Luuuy2007/stm32-wenshidujiance/README.md

# 基于STM32的温湿度检测系统

摘　　要
针对仓储、机房与实验室等场合对温湿度巡检的低功耗与低成本要求，设计一款以 STM32G030K6T6 为主控的便携式温湿度检测装置。硬件以 SHT40 数字传感器为测量单元，经 I²C1 接口读取原始数据并按器件手册给出的线性关系换算温度与相对湿度；显示单元由三片 SN74HC595 移位寄存器分别承担段码与位选驱动，构成两组三位共阴数码管的动态扫描电路；供电取自两节 AAA 电池，经 P 沟道场效应管接入系统电源网络，并由磁珠隔离出单片机专用电源，另设电阻分压支路用于电池电压采样。软件采用事件驱动的休眠唤醒结构，按键下降沿经外部中断唤醒内核，定时器周期触发中断完成六位数码管刷新，中断服务程序的实际刷新周期约为 330 μs，刷新计数达到设定门限后关闭显示并返回睡眠，使装置绝大部分时间处于等待状态。工程编译结果为代码 10120 字节、只读数据 352 字节、读写数据 48 字节与未初始化数据 1896 字节，占用 Flash 约 10.3 kB、RAM 约 1.9 kB。电路仿真结果显示电源分压与电池采样、总线上升沿时间以及段驱动电流均处于设计允许范围。
关键词：STM32G030；SHT40；温湿度检测；移位寄存器；动态扫描；低功耗

第 1 章  绪论
1.1 课题背景与意义
温湿度是仓储、生产车间、机房与实验室中最常被监测的两类环境参数。粮食与药品在湿度偏高的环境中容易吸潮霉变，精密仪器在温度波动较大的场合会出现零点漂移，档案库房与古籍阅览室对湿度变化的敏感程度也远高于一般房间[1]。人工巡检依赖手持仪表逐点记录，采样间隔长，数据无法连续反映环境变化，遇到多点位场所时人力成本迅速上升。固定式监测系统解决了连续性的问题，其代价是布线复杂、安装位置受限，对于临时点位或空间狭小的场所并不适用。
嵌入式技术的成熟使便携式检测装置具备了实用条件。微控制器集成度提高、数字传感器出厂即完成标定、电池供电下的静态电流降到微安级，这三项变化让一台小型装置可以长期值守而无需外部电源。本课题以温湿度检测装置为对象，研究在有限硬件资源与电池供电约束下的电路与程序设计方法，对同类便携式环境检测设备的开发具有参考价值，也符合电气工程及其自动化专业在嵌入式系统与电力电子器件应用方面的培养要求。
1.2 国内外研究现状
低功耗设计是此类装置的研究重点。有研究以 STM32 微控制器为核心构建物联网设备，从系统架构、外设使能与通信技术三个层面讨论功耗控制策略，测试结果表明优化后的整机功耗明显下降[2]。采集环节的功耗控制依赖器件的休眠管理与外设电源通断，有研究在数据采集仪中选用低功耗微控制器，利用场效应管切换外设供电，并在软件中采用定时休眠策略降低整机平均电流[3]。面向特定场所的温湿度传感装置也有专门设计，有研究为空间狭小且易受潮的变电站端子箱开发了兼具无线与有线通信功能的多功能传感器，采用低功耗微处理器与集成温湿度敏感元件，适应了柜内环境的安装与维护条件[4]。
数据采集系统的架构设计积累了较多工程经验。面向烟草仓库的嵌入式监测系统将温湿度数据与图像数据融合，由数据采集节点、云服务器与远程监控终端三部分构成，其中采集节点以 ESP32 为核心完成环境参数的获取与上传[5]。针对固体表面温湿度的多路监测系统采用 STM32 作为主控，通过多路传感器实现对被测表面的连续采集，在腐蚀环境下的适应性得到验证[1]。成本与能耗的平衡也有专门讨论，基于近场通信的低能耗温湿度记录系统中，NFC 标签与主控芯片按需供电，降低了系统对电池容量的依赖[6]。传感器本身的精度保持问题同样受到重视，有研究依据数字式温湿度计校准规范对测量结果的不确定度进行分析评定，给出校准过程中的注意事项，指出定期校准是维持长期测量可信度的必要手段[7]。
现有研究多面向网络化、多点位的监测场景，通信模块与云端服务占据较大比重，对于单人操作、单点巡检的便携式仪表讨论相对较少。显示环节的技术选择也少有专门分析，而数码管动态扫描与移位寄存器驱动在低成本方案中具有典型意义。本文以一台便携式温湿度检测装置为对象，围绕供电、采集、显示与休眠四个环节展开设计，在不引入无线通信模块的前提下，通过事件驱动结构与器件选型降低整机功耗与成本。
1.3 主要研究内容
本文的研究工作包含硬件电路设计、嵌入式软件设计与电路仿真验证三部分。硬件部分完成电源通路与电池电压采样、单片机最小系统、数字传感器接口、移位寄存器显示驱动以及按键唤醒电路的设计，并给出元器件清单与印制板布局。软件部分完成系统时钟与外部设备的初始化、传感器数据读取与换算、数码管动态扫描刷新以及按键唤醒与休眠状态管理，给出各功能模块的程序流程与关键参数。仿真部分在电路仿真平台上对电源分压、总线上升沿与段驱动电流进行校核，以验证设计参数处于允许范围。

第 2 章  系统总体方案设计
2.1 功能需求与技术指标
装置面向单点巡检场景，要求在无人操作时保持低功耗待机，按下按键后立即读取当前温湿度并以数字形式显示，显示维持数秒后自动熄灭返回待机。测量范围覆盖常温环境，温度在 0 ℃ 至 50 ℃ 之间，相对湿度在 20 %RH 至 90 %RH 之间，温度分辨力不低于 0.1 ℃，湿度分辨力不低于 0.1 %RH。装置由两节 AAA 电池供电，待机状态下的电流应控制在微安量级，以满足长期值守的要求。整机体积受便携性约束，印制板尺寸为 60.0 mm × 30.0 mm。
2.2 主控芯片选型
主控承担数据读取、数值换算、显示扫描与休眠管理的任务，对运算能力要求不高，对静态功耗与封装尺寸要求较高。表 2-1 对三种常见方案进行了比较。STC89C52RC 属于传统 8051 内核，程序存储器与数据存储器容量偏小，片上外设有限，需要外加模数转换与较多辅助电路。STM32F103C8T6 采用 Cortex-M3 内核，资源充裕，封装为 LQFP48，静态电流与成本均高于本设计所需。STM32G030K6T6 属于 Cortex-M0+ 内核，主频 64 MHz，程序存储器 32 kB，数据存储器 8 kB，通用输入输出端口 30 个，工作电压 2 V 至 3.6 V，封装为 LQFP32，睡眠模式下电流较小，与两节 AAA 电池供电的方案匹配。
表 2-1  主控芯片方案比较
方案	内核	主频	程序存储器	数据存储器	封装	结论
STC89C52RC	8051	12 MHz	8 kB	512 B	DIP40	外设不足
STM32F103C8T6	Cortex-M3	72 MHz	64 kB	20 kB	LQFP48	成本与功耗偏高
STM32G030K6T6	Cortex-M0+	64 MHz	32 kB	8 kB	LQFP32	选用
2.3 温湿度传感器选型
传感器决定测量精度与接口复杂度。DHT11 采用单总线接口，价格低，精度为温度 ±2 ℃、湿度 ±5 %RH，分辨率较低，采集周期不低于 1 s，用于巡检仪表时误差偏大。SHT30 采用 I²C 接口，精度为温度 ±0.3 ℃、湿度 ±2 %RH，供电范围 2.4 V 至 5.5 V，性能满足要求。SHT40 同为 I²C 接口，精度提升至温度 ±0.2 ℃、湿度 ±1.8 %RH，供电范围 1.08 V 至 3.6 V，与 3 V 电池系统的电压区间吻合，无需额外稳压，且高精度测量命令的转换时间仅数毫秒，适合按键触发式的即时读取。三种方案的比较见表 2-2。

表 2-2  温湿度传感器方案比较
方案	接口	温度精度	湿度精度	供电范围	结论
DHT11	单总线	±2 ℃	±5 %RH	3.3 V ~ 5.5 V	精度不足
SHT30	I²C	±0.3 ℃	±2 %RH	2.4 V ~ 5.5 V	可用
SHT40	I²C	±0.2 ℃	±1.8 %RH	1.08 V ~ 3.6 V	选用
2.4 显示方案选型
显示单元需要在弱光环境下保持可读性，同时避免持续点亮的功耗。液晶字符模块 LCD1602 需要背光才能看清，背光电流通常在毫安级，与低功耗目标冲突，且低温下响应变慢。有机发光二极管模块对比度高、视角大，但成本与老化问题使其不适合长期值守的仪表。三位共阴数码管配合动态扫描的工作方式具有亮度高、成本低、静态不耗电的特点，显示仅在按键触发后的短暂时段内进行，与休眠结构契合。为压缩单片机端口占用，位数码管的段码与位选均由移位寄存器驱动，三种方案的比较见表 2-3。
表 2-3  显示方案比较
方案	显示内容	驱动方式	静态功耗	结论
LCD1602	字符两行	并口或 I²C	背光开启时毫安级	功耗偏高
OLED 模块	自发光点阵	I²C 或 SPI	点亮时毫安级	成本与老化
三位共阴数码管	两组三位数字	移位寄存器动态扫描	熄灭时不耗电	选用
2.5 系统总体结构
装置由供电、采集、主控、显示、交互与检测六个功能单元构成。两节 AAA 电池经 P 沟道场效应管接入系统电源网络，磁珠将单片机供电与外围供电隔离，抑制数字开关噪声对内核的干扰。温湿度传感器经四脚插座与 I²C1 总线连接，两条信号线各配一只上拉电阻。三片移位寄存器分别承担两只数码管的段码驱动与公共端位选，形成三组独立的串行接口，由单片机的六个端口分时控制。轻触开关一端接地、另一端接单片机的外部中断引脚，承担唤醒功能。电池电压经电阻分压后送入模数转换通道，用于电量估计。系统总体结构见图 2-1。

图 2-1  系统总体结构框图
2.6 器件成本与功耗估算
整机物料成本由芯片、显示器件与无源元件三部分构成。主控芯片选用 32 位内核的低成本型号，单价与常见 8 位机相当而外设资源更完整，省去了外部模数转换与存储扩展的开支。两只三位数码管与三片移位寄存器的组合总价低于同尺寸液晶模块，且不依赖背光，减少了长期运行的电能开销。阻容元件全部采用 0603 封装，贴片化布置有利于批量焊接与小型化。
功耗方面，装置在待机状态下内核处于等待中断模式，外设时钟除保持中断唤醒所需的端口外均被关闭，数码管与指示灯全部熄灭，电流消耗以场效应管的漏电流与阻容元件漏电流为主，处于微安量级。按键触发后的工作时段包含一次传感器测量与约 3.3 s 的显示刷新，段驱动电流平均值约 2.5 mA，其余外设处于空闲状态，按此估算，两节 AAA 电池在每日触发十次的典型使用频率下，续航明显长于常规巡检仪表的电池更换周期。

第 3 章  硬件电路设计
3.1 电源通路与电池电压检测
装置采用两节 AAA 电池串联供电，标称电压 3 V。电池正极直接引出 VBAT 网络，经 P 沟道场效应管 Q1 接入 3V 网络，管子的栅极接地使沟道保持导通，源漏之间的导通电阻为 52 mΩ，在百毫安级负载下产生的压降不超过数十毫伏。该管的接法同时承担电池反接保护，电池极性接反时栅源电压随之反向，沟道关断，后级电路与单片机不会因反向电压而损坏。单片机供电由 3V 网络经磁珠 L1 引出，形成独立的 VDD 网络，磁珠在 100 MHz 处的阻抗为 120 Ω，可将数码管动态扫描产生的高频开关噪声挡在内核供电之外。VDD 与地之间就近放置 100 nF 电容 C2，为内核提供高频去耦通路，3V 网络上并联四只 1 μF 电容 C5 至 C7 与 C9，用于抑制负载突变引起的电压波动。
电量检测由电阻 R6 与 R7 构成的分压支路完成。3V 网络经 R6 引入采样点 BAT_VOL，该点再经 R7 接地，两只电阻同为 10 kΩ，分压比为二分之一，3 V 电池电压在采样点上形成约 1.5 V 的直流分量，处于模数转换通道的输入范围之内。采样点并联 100 nF 电容 C8，滤除按键操作引起的瞬态干扰。采样信号接入单片机的 PB1 端口，该端口复用为模数转换通道 ADC1_IN9，转换器的采样时间配置为 160.5 个时钟周期，以适应分压支路较高的等效源阻抗。电源通路与电量检测电路见图 3-1。

图 3-1  电源通路与电池电压检测电路
3.2 单片机最小系统
单片机采用 STM32G030K6T6，封装为 LQFP32，程序存储器容量 32 kB，数据存储器容量 8 kB，通用输入输出端口 30 个，最高主频 64 MHz。时钟源选用内部高速振荡器，无需外部晶振即可启动，降低了物料成本与布板难度。复位电路由上拉电阻 R1 与电容 C1 构成，R1 取 10 kΩ 接至 3V 网络，C1 取 100 nF 接地，上电时电容两端电压不能突变，将复位引脚拉低一段时间，保证内部寄存器的可靠初始化。
仿真器与调试接口采用四针排针 H1，依次为 3V、地、时钟线与数据线，接至单片机的 PA13 与 PA14 端口，两端口分别复用为串行线调试的数据线与时钟线，下载程序与在线调试均通过该接口完成。板上另行接入 32.768 kHz 晶振 X1，两端分别接至 PC14 与 PC15 端口，各配 18 pF 负载电容 C3 与 C4。外部低速晶振在本设计中并未启用，配置文件中保留其引脚定义，为后续增加实时时钟与定时唤醒功能预留条件。单片机最小系统电路见图 3-2。

图 3-2  单片机最小系统电路
3.3 温湿度采集电路
温湿度传感器 SHT40 通过四脚插座 U2 接入，插座间距 1.27 mm，引脚依次为数据线、地、电源与时钟线。数据线 SHT40_SDA 接至单片机的 PB9 端口，时钟线 SHT40_SCL 接至 PB8 端口，二者分别复用为 I²C1 的数据与时钟信号，引脚配置为开漏输出模式并工作在 7 位地址方式，从机地址为 0x44。开漏输出无法主动拉高电平，两条信号线各接一只 4.7 kΩ 上拉电阻 R2 与 R3 至 3V 网络，总线在空闲状态由电阻拉至电源电平。传感器与单片机在同一块印制板上，总线走线短、分布电容小，4.7 kΩ 的上拉阻值与 400 kHz 的通信速率相适应，兼顾了上升沿速度与静态功耗。采集电路见图 3-3。

图 3-3  温湿度采集电路
3.4 显示驱动电路
显示单元由两只三位共阴数码管与三片 SN74HC595 移位寄存器组成。数码管型号为 FJ2381AH，字高 0.28 英寸，八段笔画按 A 至 H 顺序引出，其中 H 段为小数点，六个公共端分别对应两排数字的三位。移位寄存器 U3 的八路输出接第一只数码管的八段笔画，U4 的八路输出接第二只数码管的八段笔画，U5 的八路输出中有七路分别接两只数码管的六个公共端与一只信号指示灯，组成位选驱动。三片寄存器各自拥有独立的串行数据线、移位时钟线与锁存时钟线，并未采用级联连接，这样每片寄存器可以单独刷新，避免了级联方式下十六位串行传输带来的额外时间开销。
芯片的使能端接地使输出保持有效，清零端接至 3V 网络避免误清零，电源与地之间就近配置去耦电容。共阴极数码管的公共端由 U5 输出驱动，输出低电平时对应的位被选中，段码由 U3 与 U4 输出高电平点亮，两个方向的驱动电流均在器件允许范围之内。显示驱动电路见图 3-4。

图 3-4  显示驱动电路
3.5 按键唤醒电路
轻触开关 SW1 为单刀单掷结构，触点额定电流 50 mA，机械寿命 10 万次，一端接地，另一端经 WAKE 网络接至单片机的 PB5 端口。该端口配置为下降沿触发的外部中断输入，内部上拉电阻使能，开关断开时端口保持高电平，按下时端口经开关接地，产生下降沿触发中断。内部上拉免去了外部上拉电阻，简化了电路。板上另设两只蓝色发光二极管。LED4 作为工作指示，阳极经 4.7 kΩ 限流电阻 R5 接至 3V 网络，阴极接至 PB7 端口，端口输出高电平时指示灯熄灭，输出低电平时点亮，该引脚在初始化阶段被置为高电平，与软件中关闭指示灯的操作一致。LED3 作为信号指示，阳极经 4.7 kΩ 限流电阻 R4 接至 3V 网络，阴极接至位选寄存器 U5 的 Q6 输出端，驱动路径已在 3.4 节的显示驱动电路中给出，当前固件未点亮该指示，作为运行状态的预留通道。按键与指示电路见图 3-5。

图 3-5  按键唤醒与指示电路
3.6 元器件清单与印制板布局
整板共 31 个元器件，包含主控芯片一只、移位寄存器三片、三位共阴数码管两只、场效应管一只、电池盒一只、连接器与排针各一只、晶振一只、磁珠一只、发光二极管两只、轻触开关一只、贴片电阻七只与贴片电容九只。元器件清单见表 3-1，其中电阻与电容按标称阻值、容值与精度列入。
表 3-1  元器件清单
序号	位号	名称与规格	封装	数量
1	U1	STM32G030K6T6 微控制器	LQFP32	1
2	U3, U4, U5	SN74HC595PWR 移位寄存器	TSSOP-16	3
3	LED1, LED2	FJ2381AH 三位共阴数码管	直插 0.28 英寸	2
4	U2	X1311FR-04-C43D24 四脚插座	1.27 mm 间距	1
5	H1	X6511WV-04H-C60D30 四针排针	2.54 mm 间距	1
6	Q1	WST3401 P 沟道场效应管	SOT-23-3	1
7	BAT1	BH-AAA-A1AJ020 电池盒	AAA 直插	1
8	X1	X321532768KGD2SI 晶振 32.768 kHz	SMD 3.2×1.5	1
9	L1	PBBMAQ2012G-121T08 磁珠 120 Ω	0805	1
10	SW1	GT-TC018A-H0375-L1 轻触开关	卧贴 4.7×3.5	1
11	LED3, LED4	XL-1608UBC-04 蓝色发光二极管	0603	2
12	R6, R7	AR03BTCX1002 精密电阻 10 kΩ ±0.1 %	0603	2
13	R1	0603WAF1002T5E 电阻 10 kΩ ±1 %	0603	1
14	R2, R3, R4, R5	0603WAF4701T5E 电阻 4.7 kΩ ±1 %	0603	4
15	C1, C2, C8	CC0603KRX7R9BB104 电容 100 nF X7R	0603	3
16	C5, C6, C7, C9	CL10A105KB8NNNC 电容 1 μF X5R	0603	4
17	C3, C4	CL10C180JB8NNNC 电容 18 pF C0G	0603	2
印制板采用长 60.0 mm、宽 30.0 mm 的矩形板框，四角圆角半径为 2.0 mm。板面按功能划分为三个区域，左侧布置电池盒与调试排针，中部集中放置单片机、晶振与电源器件，右侧放置三片移位寄存器与两只数码管。传感器插座布置在板右上方并与单片机保持短距离走线，两只上拉电阻紧靠插座放置。数码管沿板长方向排列，位选寄存器置于两只数码管之间以缩短位选走线。电池盒布置在板背面，以节省正面面积。印制板元件布局见图 3-6。

图 3-6  印制板元件布局图

第 4 章  软件设计
4.1 软件总体结构
程序以事件驱动方式组织，不使用操作系统。上电后完成系统初始化，随即关闭显示并进入睡眠状态，内核在等待中断指令处挂起，绝大部分时间不再执行任何指令。按键按下时外部中断置位按键状态标志并恢复系统滴答定时器，主循环检测到标志后读取传感器数据、启动定时器刷新显示，刷新计数达到门限后关闭显示并重新进入睡眠。整个程序由主循环、中断服务程序与若干功能函数构成，模块之间通过全局结构体变量传递状态，结构简单且时序可控。主程序流程见图 4-1。

图 4-1  主程序流程图
4.2 系统时钟与外设初始化
系统时钟由内部高速振荡器经锁相环倍频得到。内部振荡器标称频率 16 MHz，锁相环输入分频系数取 1，倍频系数取 8，输出分频系数取 2，压控振荡器输出 128 MHz，经分频后系统时钟为 64 MHz，总线时钟与定时器时钟同为 64 MHz。闪存等待周期设置为 2 个周期，与 64 MHz 的主频相适应。时钟配置在系统时钟函数中完成，配置失败时进入错误处理函数并关闭中断。
外设初始化按端口、模数转换、串行总线与定时器的顺序执行。端口初始化将十个引脚配置为推挽输出并设置最高翻转速度，用于驱动三组移位寄存器，另将指示灯引脚置为高电平状态。串行总线配置为 7 位地址方式，时序寄存器按 64 MHz 时钟与 400 kHz 速率写入固定参数，模拟滤波器使能、数字滤波器关闭。定时器配置为向上计数模式，预分频系数 63，自动重装值 29，更新中断使能，中断优先级低于外部中断但高于滴答定时器。各初始化函数由代码生成工具产生，用户代码段保持独立，便于后续修改。
4.3 温湿度数据读取与换算
读取函数通过 I²C1 总线以主机发送方式向传感器写入单字节命令 0xFD，该命令对应最高重复性下的温湿度测量，转换时间约 8.3 ms，程序调用延时函数等待 10 ms 以保证转换完成。随后以主机接收方式读回六个字节，依次为温度高字节、温度低字节、温度校验字节、湿度高字节、湿度低字节与湿度校验字节。温度与湿度的原始值均为 16 位无符号数，按器件手册给出的线性关系换算，温度等于原始值乘以 175 除以 65535 再减去 45，相对湿度等于原始值乘以 125 除以 65535 再减去 6。十六位原始值对应 175 ℃ 的温度跨度，理论分辨力约为 0.0027 ℃，换算结果乘以十并取整后存入设备参数结构体，整型变量的分辨力为 0.1 ℃，满足显示要求。读取流程见图 4-2。

图 4-2  温湿度数据读取流程
4.4 数码管动态扫描与显示刷新
显示采用分时扫描方式，六个数字位由位选寄存器依次选通，段码寄存器同步输出对应当前位的笔画编码。位选编码为八位数据，仅有一位为低电平，其余位为高电平，低电平位对应的数码管公共端被拉低而点亮。两排数字的位选编码分别为 0xFE、0xFD、0xFB 与 0xF7、0xEF、0xDF，分别对应第一只数码管的三个位与第二只数码管的三个位。段码采用七段编码表，数字 0 至 9 的编码依次为 0x3F、0x06、0x5B、0x4F、0x66、0x6D、0x7D、0x07、0x7F 与 0x6F，小数点的编码为 0x80。十位数字的段码与 0x80 按位或运算后写入寄存器，使十位后的小数点常亮，从而以一位小数的形式显示测量结果，段码表见表 4-1，位选编码见表 4-2。
表 4-1  数码管段码表
显示字符	段码	显示字符	段码
0	0x3F	5	0x6D
1	0x06	6	0x7D
2	0x5B	7	0x07
3	0x4F	8	0x7F
4	0x66	9	0x6F
表 4-2  数码管位选编码表
显示位置	位选编码	选通位	显示内容
第一排第 1 位	0xFE	U5 输出第 0 位	温度百位
第一排第 2 位	0xFD	U5 输出第 1 位	温度十位带小数点
第一排第 3 位	0xFB	U5 输出第 2 位	温度个位
第二排第 1 位	0xF7	U5 输出第 3 位	湿度百位
第二排第 2 位	0xEF	U5 输出第 4 位	湿度十位带小数点
第二排第 3 位	0xDF	U5 输出第 5 位	湿度个位
位选与段码的写入由移位函数完成。函数按照高位在前的顺序逐位输出数据，每输出一位时先将数据线置为对应电平，再在移位时钟线上产生一个上升沿，使数据移入寄存器，八位数据全部移入后在锁存时钟线上产生上升沿，将移位结果送入输出寄存器。每次显示一位后调用约 50 μs 的延时函数，随后将段码寄存器清零以消除残影，避免相邻位之间因余辉产生错位显示。定时器中断服务程序先关闭中断，依次刷新六个数字位，再将计数器清零并重新启动中断，刷新计数变量同步自增，用于判断是否达到休眠门限。定时器中断流程见图 4-3。

图 4-3  定时器中断与显示刷新流程
4.5 按键唤醒与低功耗管理
低功耗管理依靠内核睡眠模式与中断唤醒机制实现。进入睡眠之前，程序关闭数码管与指示灯的全部输出，随后调用挂起滴答定时器函数停止系统滴答计数，再执行等待中断指令使内核停止取指。系统滴答定时器在睡眠期间若继续计数，其周期性中断会不断将内核唤醒，挂起滴答定时器是保证内核持续处于睡眠状态的前提。按键按下时，PB5 端口产生下降沿，外部中断线触发中断服务程序，回调函数将按键状态置为消抖状态并恢复滴答定时器，内核随即从等待中断指令之后继续执行。主循环检测到按键状态标志后再次读取端口电平确认按键确实按下，并等待电平恢复以避免重复触发。休眠与唤醒的状态转移见图 4-4。

图 4-4  休眠与唤醒状态转移图
4.6 关键参数计算
显示刷新周期由定时器参数与刷新耗时共同决定。定时器计数时钟为 1 MHz，自动重装值为 29，定时周期为 30 μs。中断服务程序每次刷新六个数字位，每个数字位的位移输出耗时约数微秒，消影延时约 50 μs，单次中断处理耗时约 300 μs，明显大于定时周期，因此实际刷新周期由处理耗时决定，约为 330 μs，六位数码管的完整刷新率接近 3 kHz，远高于人眼产生闪烁感所需的 50 Hz。刷新计数门限设为 5000 次，对应的显示维持时间约为 1.65 s，计数溢出两次后进入休眠，装置从按下按键到自动熄灭的总时间约为 3.3 s。关键参数的计算结果见表 4-3。
表 4-3  关键参数计算结果
参数	算式	结果
系统时钟	16 MHz × 8 ÷ 2	64 MHz
定时器计数时钟	64 MHz ÷ (63 + 1)	1 MHz
定时器中断周期	(29 + 1) ÷ 1 MHz	30 μs
显示维持时间	5000 × 330 μs	约 1.65 s
自动熄灭时间	2 × 1.65 s	约 3.3 s
数码管刷新率	1 ÷ 330 μs	约 3 kHz
显示分辨力	1 ÷ 10	0.1 ℃
程序编译采用 ARM 编译器第五版，优化等级为最高级，编译结果为代码 10120 字节、只读数据 352 字节、读写数据 48 字节与未初始化数据 1896 字节，无错误与警告。按此结果计算，程序占用闪存约 10.3 kB，占 32 kB 容量的百分之三十二，运行时占用数据存储器约 1.9 kB，占 8 kB 容量的百分之二十四，存储资源留有余量，可支撑后续增加实时时钟、数据存储与通信功能。

第 5 章  电路仿真与结果分析
5.1 仿真平台与模型建立
本章通过解析计算与电路仿真两种方式对关键节点进行校核，仿真在立创EDA 专业版环境中进行，模型直接取自原理图对应的网络连接，元器件参数按元器件清单中的标称值设定，未参与仿真验证的模块在模型中予以简化。校核对象集中在三处需要定量确认的环节，分别为电池分压采样支路、I²C 总线的上拉与上升沿，以及数码管的段驱动电流。这三处决定了采样通道可用性、通信可靠性与显示器件工作余量，其余部分属于数字逻辑连接，通过程序流程与引脚配置即可确认，不再单独仿真。
5.2 电池分压与采样校核
分压支路由两只 10 kΩ 电阻串联构成，分压比为一比一，采样模型与等效电路见图 5-1。电池电压为标称值 3 V 时，采样点电压为 1.5 V，处于模数转换通道的线性输入范围之内。分压支路的等效源阻抗为两只电阻的并联值 5 kΩ，与采样点并联的 100 nF 电容构成一阶低通网络，时间常数约为 500 μs，对应截止频率约 318 Hz，可以滤除按键动作与数码管扫描引入的高频扰动，同时对缓慢变化的电池电压不产生衰减。转换器采样时间设置为 160.5 个时钟周期，在 64 MHz 的转换时钟下对应约 2.5 μs 的采样窗口，远小于滤波网络的时间常数，采样期间电容电压的跌落可以忽略。采样通道在当前固件中未启用，作为电量显示的预留接口保留。

图 5-1  电池分压采样等效电路
5.3 I²C 总线上升沿校核
总线的两条信号线各经一只 4.7 kΩ 电阻上拉至 3V 网络，仿真模型与上升沿计算曲线见图 5-2。总线分布电容的取值由走线长度与器件引脚电容决定，本设计中传感器插座与单片机相邻，走线长度不足 50 mm，分布电容按 50 pF 估算。上拉电阻与分布电容构成充电回路，时间常数为 235 ns，电压由 0.3 倍电源电压上升至 0.7 倍电源电压所需的时间为 199 ns。I²C 快速模式对这一区间上升时间的要求为不超过 300 ns，标准模式的要求为不超过 1000 ns，两种模式下 4.7 kΩ 的上拉阻值均留有裕量。阻值继续增大会使上升沿变缓，减小则会抬高总线被拉低时的瞬时电流，4.7 kΩ 在上升速度与静态电流之间取得平衡。总线空闲时两条信号线由上拉电阻维持高电平，不消耗静态电流，与低功耗目标一致。

图 5-2  I²C 总线等效模型与上升沿计算曲线
5.4 段驱动电流校核
数码管的段码由移位寄存器直接驱动，未设串联限流电阻，驱动电流路径见图 5-3。电流由电源电压、发光二极管正向压降与移位寄存器输出内阻共同决定。红色发光二极管在正常工作电流下的正向压降约为 1.9 V，3 V 供电时输出端与二极管之间的电位差约 1.1 V，移位寄存器在高电平输出状态下的等效内阻约为 70 Ω，据此估算段电流峰值约为 15 mA。器件单引脚输出的绝对最大电流为 35 mA，峰值电流处于允许范围之内。显示采用动态扫描方式，每只数码管的三个位依次点亮，单个位的导通时间占完整刷新周期的六分之一，段电流的平均值降至约 2.5 mA，发光亮度在扫描频率接近 3 kHz 时不会出现可察觉的频闪。

图 5-3  段驱动电流路径
5.5 仿真结果汇总
三处校核环节的关键量值与判定结果汇总于表 5-1。电源分压支路的采样电压、总线上升时间与段电流峰值均处于设计允许范围，设计参数无需调整。分压支路的两只精密电阻精度为 ±0.1 %，温度系数为 ±25 ppm/℃，在常温范围内的分压比误差可忽略；上拉电阻的精度为 ±1 %，对上升时间的影响小于百分之二。综合三处校核结果，电路参数满足测量、通信与显示三方面的功能要求。
表 5-1  仿真校核结果汇总
校核项目	参数设置	计算结果	判定限值	结论
采样点电压	R6 = R7 = 10 kΩ，电池 3 V	1.50 V	0 ~ 3 V	满足
滤波截止频率	5 kΩ ∥ 100 nF	318 Hz	低于扰动频率	满足
I²C 上升时间	4.7 kΩ，总线电容 50 pF	199 ns	快速模式 ≤ 300 ns	满足
段电流峰值	3 V 供电，输出内阻约 70 Ω	约 15 mA	≤ 35 mA	满足
段电流平均值	动态扫描占空比 1/6	约 2.5 mA	低于连续额定值	满足

第 6 章  结论与展望
6.1 结论
本文设计了一台以 STM32G030K6T6 为主控的便携式温湿度检测装置，完成了硬件电路设计、嵌入式软件设计与电路参数校核三部分工作。硬件方面，装置以两节 AAA 电池供电，经 P 沟道场效应管接入系统电源网络并用磁珠隔离单片机电源，数字传感器 SHT40 通过 I²C1 总线接入，两只 4.7 kΩ 电阻构成总线上拉，三片 SN74HC595 移位寄存器以三组独立的三线接口分别驱动两只三位共阴数码管的段码与位选，轻触开关接至外部中断引脚承担唤醒功能，整板共 31 个元器件，印制板尺寸为 60.0 mm × 30.0 mm。软件方面，程序采用事件驱动结构组织，系统时钟由内部振荡器经锁相环倍频至 64 MHz，传感器数据按器件手册的线性关系换算并放大十倍取整，定时器以 30 μs 周期触发中断，中断服务程序的实际刷新周期约 330 μs，显示维持约 1.65 s 后自动熄灭，装置在按下按键到返回睡眠的整个过程中仅有一次数据采集与数秒的显示动作，其余时间内核处于等待中断状态。
编译结果显示程序占用闪存约 10.3 kB、数据存储器约 1.9 kB，在 32 kB 与 8 kB 的容量中分别占百分之三十二与百分之二十四，资源留有余量。电路校核结果表明，电池分压支路的采样电压为 1.5 V，滤波网络截止频率 318 Hz，I²C 总线在 4.7 kΩ 上拉与 50 pF 分布电容条件下上升时间为 199 ns，段驱动电流峰值约 15 mA、平均值约 2.5 mA，各项参数均处于器件允许范围，设计参数的选取是合理的。与网络化监测系统相比，本设计放弃了无线通信与云端存储，以单点即时读取为目标换取更低的静态功耗与更简单的硬件结构，适合作为仓储巡检、设备点检等场景中的便携工具。
6.2 展望
当前设计仍存在可改进之处。传感器返回的六个字节中包含两个校验字节，程序在读取时未对校验字节进行核对，总线受到干扰时可能将错误数据当作有效结果，后续可在读取函数中补充循环冗余校验的计算与判断。电池电压采样通道已在硬件与配置中预留，但未在程序中启用，增加一次转换并配合电压阈值判断即可实现低电量提示。板上接入的 32.768 kHz 晶振尚未启用，开启外部低速振荡器后可以借助实时时钟实现定时唤醒与定时记录，使装置由被动响应按键转为周期性自动采集。显示方面，两组三位数字仅能表达当前测量值，增加存储芯片后可以保留历史极值，为环境趋势判断提供依据。

致　　谢
本文的完成得到指导教师在选题、方案论证与电路调试各阶段的指导，教师在器件选型依据与低功耗设计思路方面给出的意见，使设计从最初的通用方案收敛到可实现的电路结构。感谢我的挚友为我提供了可靠的大模型和足量的Token帮助我完成制板部分的配件选型和代码部分的语法验证。在各环节中帮助过我的老师们和同学们在此一并表示感谢。
受个人水平限制，文中难免存在不足，恳请各位老师批评指正。

参考文献
[1] 王玉荣.测量固体表面温湿度的多路监测系统设计[J].自动化与仪器仪表,2024(12):214-219.
[2] 秦顾艺.基于STM32的物联网设备低功耗设计与优化[J].产业创新研究,2024(20):130-132.
[3] 程智,熊远生,高金凤.基于NB-IoT的地下管网数据采集仪设计[J].计算技术与自动化,2024(4):10-15.
[4] 张敏,方健,王勇,等.基于ZigBee无线通信的变电站端子箱温湿度传感器系统设计[J].制造业自动化,2023(2):169-174.
[5] 何强,王武.基于物联网的烟草仓库嵌入式监测系统设计[J]. 自动化与仪表, 2024(7):72-74.
[6] 黄勇萍.基于NFC的低能耗温湿度记录系统的设计与实现[J].信息与电脑(理论版),2023(3):147-149.
[7] 潘雯雯.浅谈数字式温湿度计不确定度评定及校准[J].仪器仪表标准化与计量,2025(3):40-42.

附录 A  整机原理图
整机原理图按功能划分为滤波磁珠、主控电路、复位电路、晶振电路、温湿度传感器模块、移位寄存器与寄存器滤波电容、数码管、电池电量测量电路、电池防反接电路、唤醒按键、信号指示与测试指示以及下载调试接口等单元，各单元的元件位号与网络名称与正文第 3 章一致。

图 A-1  整机原理图
原理图

附录 B  PCB 封装图
印制板采用双面布局，正面放置贴片阻容、集成电路、数码管与连接器，背面放置电池盒。板框尺寸为 60.0 mm × 30.0 mm，四角圆角半径 2.0 mm，共 31 个元件、159 个焊盘。顶层走线集中在左侧主控区与中部移位寄存器区之间，两只数码管与传感器插座布置在右侧，底层以大面积铺地与电池盒开窗为主。印制板顶层与底层图分别见图 B-1 与图 B-2。

图 B-1  印制板顶层图
印制板顶层

图 B-2  印制板底层图
印制板底层

附录 C  装配效果图
装配效果图

装配效果图给出装置的三维形态。印制板正面左侧布置单片机、电源器件与四针调试排针，中部为三片移位寄存器及其去耦电容，右侧为传感器插座与两只总线上拉电阻，两只三位共阴数码管沿板长方向并排安装并朝向正面，字面在正视方向可读。电池盒固定在印制板背面，与正面的元件位置相互错开，整机厚度主要由数码管与电池盒决定。

图 C-1  装配效果图

附录 D  元器件清单
清单按位号列出全部 31 个元器件，型号与封装信息取自原理图与封装图文件。
表 D-1  元器件清单
序号	位号	名称与规格	封装	数量
1	U1	STM32G030K6T6 微控制器	LQFP32	1
2	U2	X1311FR-04-C43D24 四脚插座 1.27 mm	弯插 4P	1
3	U3, U4, U5	SN74HC595PWR 移位寄存器	TSSOP-16	3
4	LED1, LED2	FJ2381AH 三位共阴数码管 0.28 英寸	直插	2
5	LED3, LED4	XL-1608UBC-04 蓝色发光二极管	0603	2
6	Q1	WST3401 P 沟道场效应管 30 V/5.5 A	SOT-23-3	1
7	BAT1	BH-AAA-A1AJ020 电池盒	AAA 直插	1
8	SW1	GT-TC018A-H0375-L1 轻触开关	卧贴	1
9	X1	X321532768KGD2SI 晶振 32.768 kHz	SMD 3.2×1.5	1
10	L1	PBBMAQ2012G-121T08 磁珠 120 Ω@100 MHz	0805	1
11	H1	X6511WV-04H-C60D30 四针排针 2.54 mm	直插	1
12	R1	0603WAF1002T5E 电阻 10 kΩ ±1 %	0603	1
13	R2, R3, R4, R5	0603WAF4701T5E 电阻 4.7 kΩ ±1 %	0603	4
14	R6, R7	AR03BTCX1002 电阻 10 kΩ ±0.1 %	0603	2
15	C1, C2, C8	CC0603KRX7R9BB104 电容 100 nF X7R 50 V	0603	3
16	C3, C4	CL10C180JB8NNNC 电容 18 pF C0G 50 V	0603	2
17	C5, C6, C7, C9	CL10A105KB8NNNC 电容 1 μF X5R 50 V	0603	4

附录 E  主要器件技术参数
表 E-1  主要器件技术参数
器件	参数项	数值
STM32G030K6T6	内核 / 主频	Cortex-M0+ / 64 MHz
	程序存储器 / 数据存储器	32 kB / 8 kB
	工作电压 / 封装	2 V ~ 3.6 V / LQFP32
	通用输入输出端口	30 个
SHT40	温度测量范围 / 精度	-40 ℃ ~ 125 ℃ / ±0.2 ℃
	湿度测量范围 / 精度	0 ~ 100 %RH / ±1.8 %RH
	供电范围 / 接口	1.08 V ~ 3.6 V / I²C 地址 0x44
SN74HC595PWR	功能 / 位数	串行输入并行输出 / 8 位
	电源电压 / 封装	2 V ~ 6 V / TSSOP-16
FJ2381AH	位数 / 极性	3 位 / 共阴极
	字高 / 发光颜色	0.28 英寸 / 红色
WST3401	类型 / 漏源电压	P 沟道 / 30 V
	连续漏极电流 / 导通电阻	5.5 A / 52 mΩ
X321532768KGD2SI	频率 / 常温频差	32.768 kHz / ±20 ppm
	负载电容	12.5 pF
