Luuuy2007/stm32-wenshidujiance/Core/Src/main.c

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
/* Includes ------------------------------------------------------------------*/
#include "main.h"
#include "adc.h"
#include "i2c.h"
#include "tim.h"
#include "gpio.h"


void SystemClock_Config(void);
/* USER CODE BEGIN 0 */
struct DEVICE_PARAMTER device_paramter = {0};
/* USER CODE END 0 */

/**
  * @brief  The application entry point.
  * @retval int
  */
int main(void)
{
  /* USER CODE BEGIN 1 */
	float temperature = 0;	
	float humidity = 0;
  /* USER CODE END 1 */

  /* MCU Configuration--------------------------------------------------------*/

  /* Reset of all peripherals, Initializes the Flash interface and the Systick. */
  HAL_Init();

  /* Configure the system clock */
  SystemClock_Config();

  /* USER CODE BEGIN SysInit */
	HAL_DeInit();
  /* USER CODE END SysInit */

  /* Initialize all configured peripherals */
  MX_GPIO_Init();	
  MX_ADC1_Init();
  MX_I2C1_Init();
  MX_TIM14_Init();
  /* USER CODE BEGIN 2 */
	HAL_Delay(100);
  SN74HC595_Send_Data(SN_DIG,0xFF);		//关闭数码管显示
  SN74HC595_Send_Data(SN_LED1,0x00);
  SN74HC595_Send_Data(SN_LED2,0x00);
	
  /* USER CODE END 2 */
	HAL_SuspendTick();	//暂停滴答定时器，防止通过滴答定时器中断唤醒
	HAL_PWR_EnterSLEEPMode(PWR_MAINREGULATOR_ON, PWR_SLEEPENTRY_WFI); /* 执行WFI指令, 进入睡眠模式 */
  /* Infinite loop */
  /* USER CODE BEGIN WHILE */
  while (1)
  {
    /* USER CODE END WHILE */

    /* USER CODE BEGIN 3 */
		if(device_paramter.KeyStatus == KEY_SHAKE_STATE)
		{
			HAL_Delay(10);
			if(HAL_GPIO_ReadPin(GPIOB,GPIO_PIN_5) == GPIO_PIN_RESET)
			{
				while(HAL_GPIO_ReadPin(GPIOB,GPIO_PIN_5) == GPIO_PIN_RESET);
				
				SHT40_Read_RHData(&temperature,&humidity);	//读取温湿度
				device_paramter.Temp = temperature * 10;		//放大温湿度
				device_paramter.Humi = humidity * 10;
				HAL_TIM_Base_Start_IT(&htim14);         		//开始定时器，显示两次数据 
				device_paramter.sleepStatus = 0;						//清除休眠标志
				device_paramter.KeyStatus = KEY_NO_PRESS;		//清除按下标志
			}
		}
		else if(device_paramter.sleepStatus == 1)				//显示结束，进入休眠
		{
			HAL_SuspendTick();	//暂停滴答定时器，防止通过滴答定时器中断唤醒
			HAL_PWR_EnterSLEEPMode(PWR_MAINREGULATOR_ON, PWR_SLEEPENTRY_WFI); /* 执行WFI指令, 进入睡眠模式 */
		}
  }
  /* USER CODE END 3 */
}

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
