Luuuy2007/stm32-wenshidujiance/Core/Src/i2c.c

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
/* Includes ------------------------------------------------------------------*/
#include "i2c.h"

I2C_HandleTypeDef hi2c1;

/* I2C1 init function */
void MX_I2C1_Init(void)
{

  hi2c1.Instance = I2C1;
  hi2c1.Init.Timing = 0x10707DBC;
  hi2c1.Init.OwnAddress1 = 0;
  hi2c1.Init.AddressingMode = I2C_ADDRESSINGMODE_7BIT;
  hi2c1.Init.DualAddressMode = I2C_DUALADDRESS_DISABLE;
  hi2c1.Init.OwnAddress2 = 0;
  hi2c1.Init.OwnAddress2Masks = I2C_OA2_NOMASK;
  hi2c1.Init.GeneralCallMode = I2C_GENERALCALL_DISABLE;
  hi2c1.Init.NoStretchMode = I2C_NOSTRETCH_DISABLE;
  if (HAL_I2C_Init(&hi2c1) != HAL_OK)
  {
    Error_Handler();
  }

  /** Configure Analogue filter
  */
  if (HAL_I2CEx_ConfigAnalogFilter(&hi2c1, I2C_ANALOGFILTER_ENABLE) != HAL_OK)
  {
    Error_Handler();
  }

  /** Configure Digital filter
  */
  if (HAL_I2CEx_ConfigDigitalFilter(&hi2c1, 0) != HAL_OK)
  {
    Error_Handler();
  }
}

void HAL_I2C_MspInit(I2C_HandleTypeDef* i2cHandle)
{

  GPIO_InitTypeDef GPIO_InitStruct = {0};
  RCC_PeriphCLKInitTypeDef PeriphClkInit = {0};
  if(i2cHandle->Instance==I2C1)
  {
  /** Initializes the peripherals clocks
  */
    PeriphClkInit.PeriphClockSelection = RCC_PERIPHCLK_I2C1;
    PeriphClkInit.I2c1ClockSelection = RCC_I2C1CLKSOURCE_PCLK1;
    if (HAL_RCCEx_PeriphCLKConfig(&PeriphClkInit) != HAL_OK)
    {
      Error_Handler();
    }

    __HAL_RCC_GPIOB_CLK_ENABLE();
    /**I2C1 GPIO Configuration
    PB9     ------> I2C1_SDA
    PB8     ------> I2C1_SCL
    */
    GPIO_InitStruct.Pin = GPIO_PIN_9|GPIO_PIN_8;
    GPIO_InitStruct.Mode = GPIO_MODE_AF_OD;
    GPIO_InitStruct.Pull = GPIO_NOPULL;
    GPIO_InitStruct.Speed = GPIO_SPEED_FREQ_LOW;
    GPIO_InitStruct.Alternate = GPIO_AF6_I2C1;
    HAL_GPIO_Init(GPIOB, &GPIO_InitStruct);

    /* I2C1 clock enable */
    __HAL_RCC_I2C1_CLK_ENABLE();
  }
}

void HAL_I2C_MspDeInit(I2C_HandleTypeDef* i2cHandle)
{

  if(i2cHandle->Instance==I2C1)
  {
    /* Peripheral clock disable */
    __HAL_RCC_I2C1_CLK_DISABLE();

    /**I2C1 GPIO Configuration
    PB9     ------> I2C1_SDA
    PB8     ------> I2C1_SCL
    */
    HAL_GPIO_DeInit(GPIOB, GPIO_PIN_9);

    HAL_GPIO_DeInit(GPIOB, GPIO_PIN_8);

  }
}

/* USER CODE BEGIN 1 */
/*
	函数内容：SHT40读取温湿度函数
	函数参数：float *temperature--温度参数指针
						float *humidity-----湿度参数指针
	返回值：无
*/
void SHT40_Read_RHData(float *temperature,float *humidity)
{
	uint8_t writeData[1] = {0xFD};
	uint8_t readData[6] = {0};
	uint32_t tempData = 0;
	HAL_I2C_Master_Transmit(&hi2c1, (uint16_t)SHT40_Write, (uint8_t *)writeData, 1, HAL_MAX_DELAY);
  HAL_Delay(10);
	HAL_I2C_Master_Receive(&hi2c1, (uint16_t)SHT40_Read, (uint8_t *)readData, 6, HAL_MAX_DELAY);
	
	tempData = readData[0]<<8 | readData[1];
	*temperature = (tempData * 175.0f) / 65535.0f - 45;
	
	tempData = readData[3]<<8 | readData[4];
  *humidity 	 = (tempData * 125.0f) / 65535.0f - 6;
}
/* USER CODE END 1 */
