Luuuy2007/stm32-wenshidujiance/Core/Src/tim.c

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
/* Includes ------------------------------------------------------------------*/
#include "tim.h"
#include "gpio.h"

/* USER CODE BEGIN 0 */
static uint16_t updata_flag;
static uint8_t sleep_flag;
/* USER CODE END 0 */

TIM_HandleTypeDef htim14;

/* TIM14 init function */
void MX_TIM14_Init(void)
{

  htim14.Instance = TIM14;
  htim14.Init.Prescaler = 64-1;
  htim14.Init.CounterMode = TIM_COUNTERMODE_UP;
  htim14.Init.Period = 30-1;
  htim14.Init.ClockDivision = TIM_CLOCKDIVISION_DIV1;
  htim14.Init.AutoReloadPreload = TIM_AUTORELOAD_PRELOAD_DISABLE;
  if (HAL_TIM_Base_Init(&htim14) != HAL_OK)
  {
    Error_Handler();
  }
}

void HAL_TIM_Base_MspInit(TIM_HandleTypeDef* tim_baseHandle)
{

  if(tim_baseHandle->Instance==TIM14)
  {
    /* TIM14 clock enable */
    __HAL_RCC_TIM14_CLK_ENABLE();

    /* TIM14 interrupt Init */
    HAL_NVIC_SetPriority(TIM14_IRQn, 2, 0);
    HAL_NVIC_EnableIRQ(TIM14_IRQn);
  }
}

void HAL_TIM_Base_MspDeInit(TIM_HandleTypeDef* tim_baseHandle)
{

  if(tim_baseHandle->Instance==TIM14)
  {
    /* Peripheral clock disable */
    __HAL_RCC_TIM14_CLK_DISABLE();

    /* TIM14 interrupt Deinit */
    HAL_NVIC_DisableIRQ(TIM14_IRQn);
  }
}

/* USER CODE BEGIN 1 */
/*
	函数内容：定时器更新中断回调函数
	函数参数：TIM_HandleTypeDef *htim--定时器句柄
	返回值：	无
*/
void HAL_TIM_PeriodElapsedCallback(TIM_HandleTypeDef *htim)
{
	if(htim->Instance == TIM14)
	{
		HAL_TIM_Base_Stop_IT(&htim14);
		
		{
			ShowNum(1,1,(device_paramter.Temp/100)); // 更新温度显示
			ShowNum(1,2,(device_paramter.Temp / 10 % 10));
			ShowNum(1,3,device_paramter.Temp%10);
		}
		{
			ShowNum(2,1,(device_paramter.Humi/100)); // 更新湿度显示
			ShowNum(2,2,(device_paramter.Humi / 10 % 10));
			ShowNum(2,3,device_paramter.Humi%10);
		}
	
		__HAL_TIM_SetCounter(&htim14,0);
		updata_flag++;// 检查是否进入休眠模式
        if (updata_flag > 5000)  //进入休眠模式的时间
        {
            updata_flag = 0;
            sleep_flag++;
        }
		if(sleep_flag >= 2)
		{
			sleep_flag = 0;
			device_paramter.sleepStatus = 1;
			SN74HC595_Send_Data(SN_DIG,0xFF);
			SN74HC595_Send_Data(SN_LED1,0x00);
			SN74HC595_Send_Data(SN_LED2,0x00);
		}
		else{
			HAL_TIM_Base_Start_IT(&htim14);          
		}			
	}
}
/* USER CODE END 1 */
