Luuuy2007/stm32-wenshidujiance/(commit log)

2026-09-26 基于stm32的温湿度检测装置
2026-09-26 烧录代码
2026-09-26 update pcb picture
    Removed main program code sections from the appendix, including system clock configuration, main loop, humidity and temperature reading functions, and display functions.
