Luuuy2007/stm32-wenshidujiance/(notices)

Notices in the files:
Core/Src/tim.c:
Copyright (c) 2024 STMicroelectronics.
All rights reserved.
This software is licensed under terms that can be found in the LICENSE file
